SujithPG-coder/schmitt-trigger-hysteresis-window/(notices)

Notices in the files:
README.md:
License: MIT
